YukiYuigishi/MEISHI/README.md

# MEISHI
[2022 v1.0](https://github.com/YukiYuigishi/MEISHI/tree/master/PCB/MEISHI2022)
