YukiYuigishi/MEISHI/PCB/MEISHI2022/PDF/MEISHI_Schema.pdf

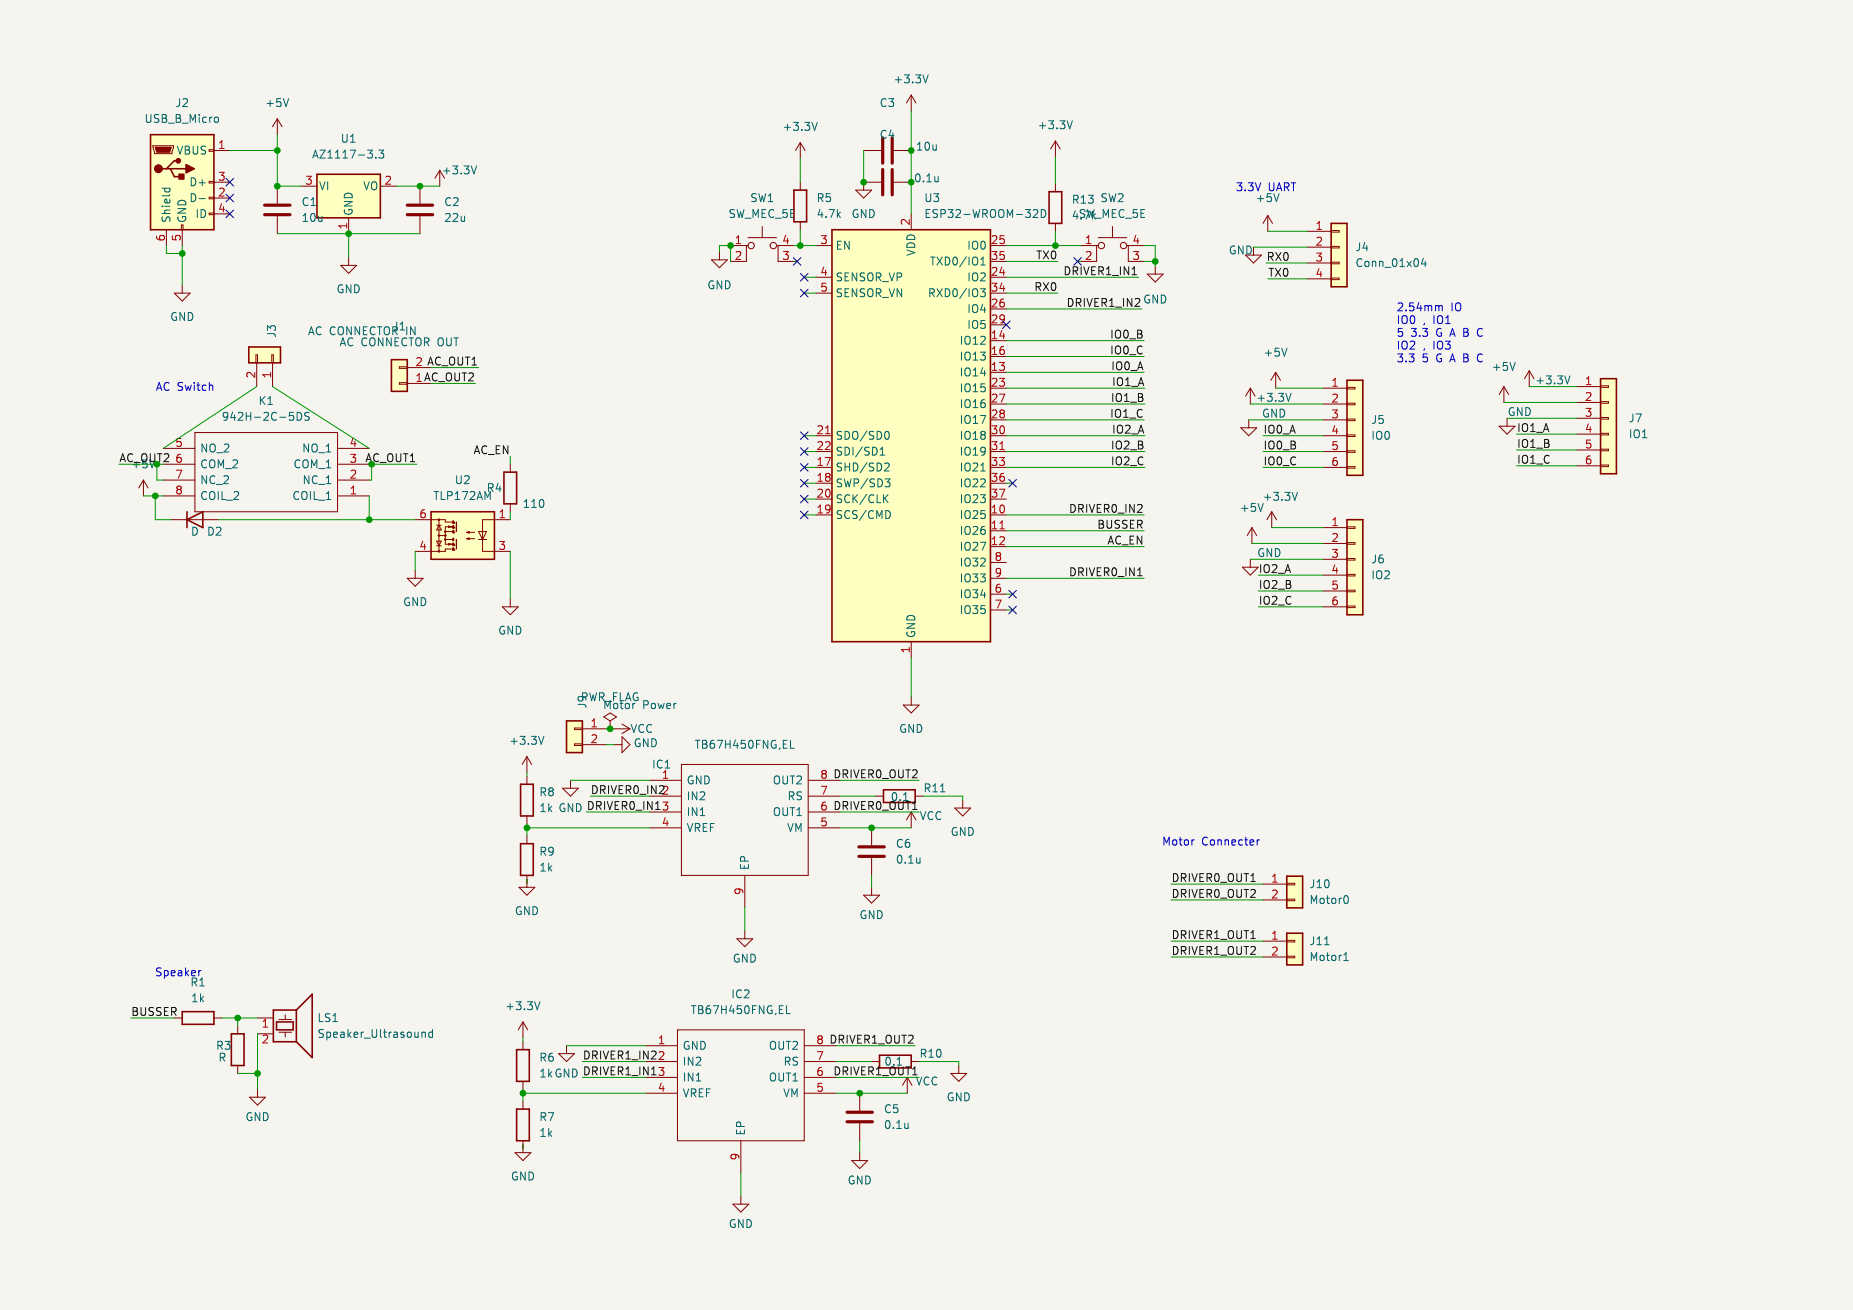
[picture p1: page 1]
