YukiYuigishi/MEISHI/PCB/MEISHI2023/MEISHI.kicad_pcb

## KiCad design PCB/MEISHI2023/MEISHI.kicad_pcb (2023-08-06)

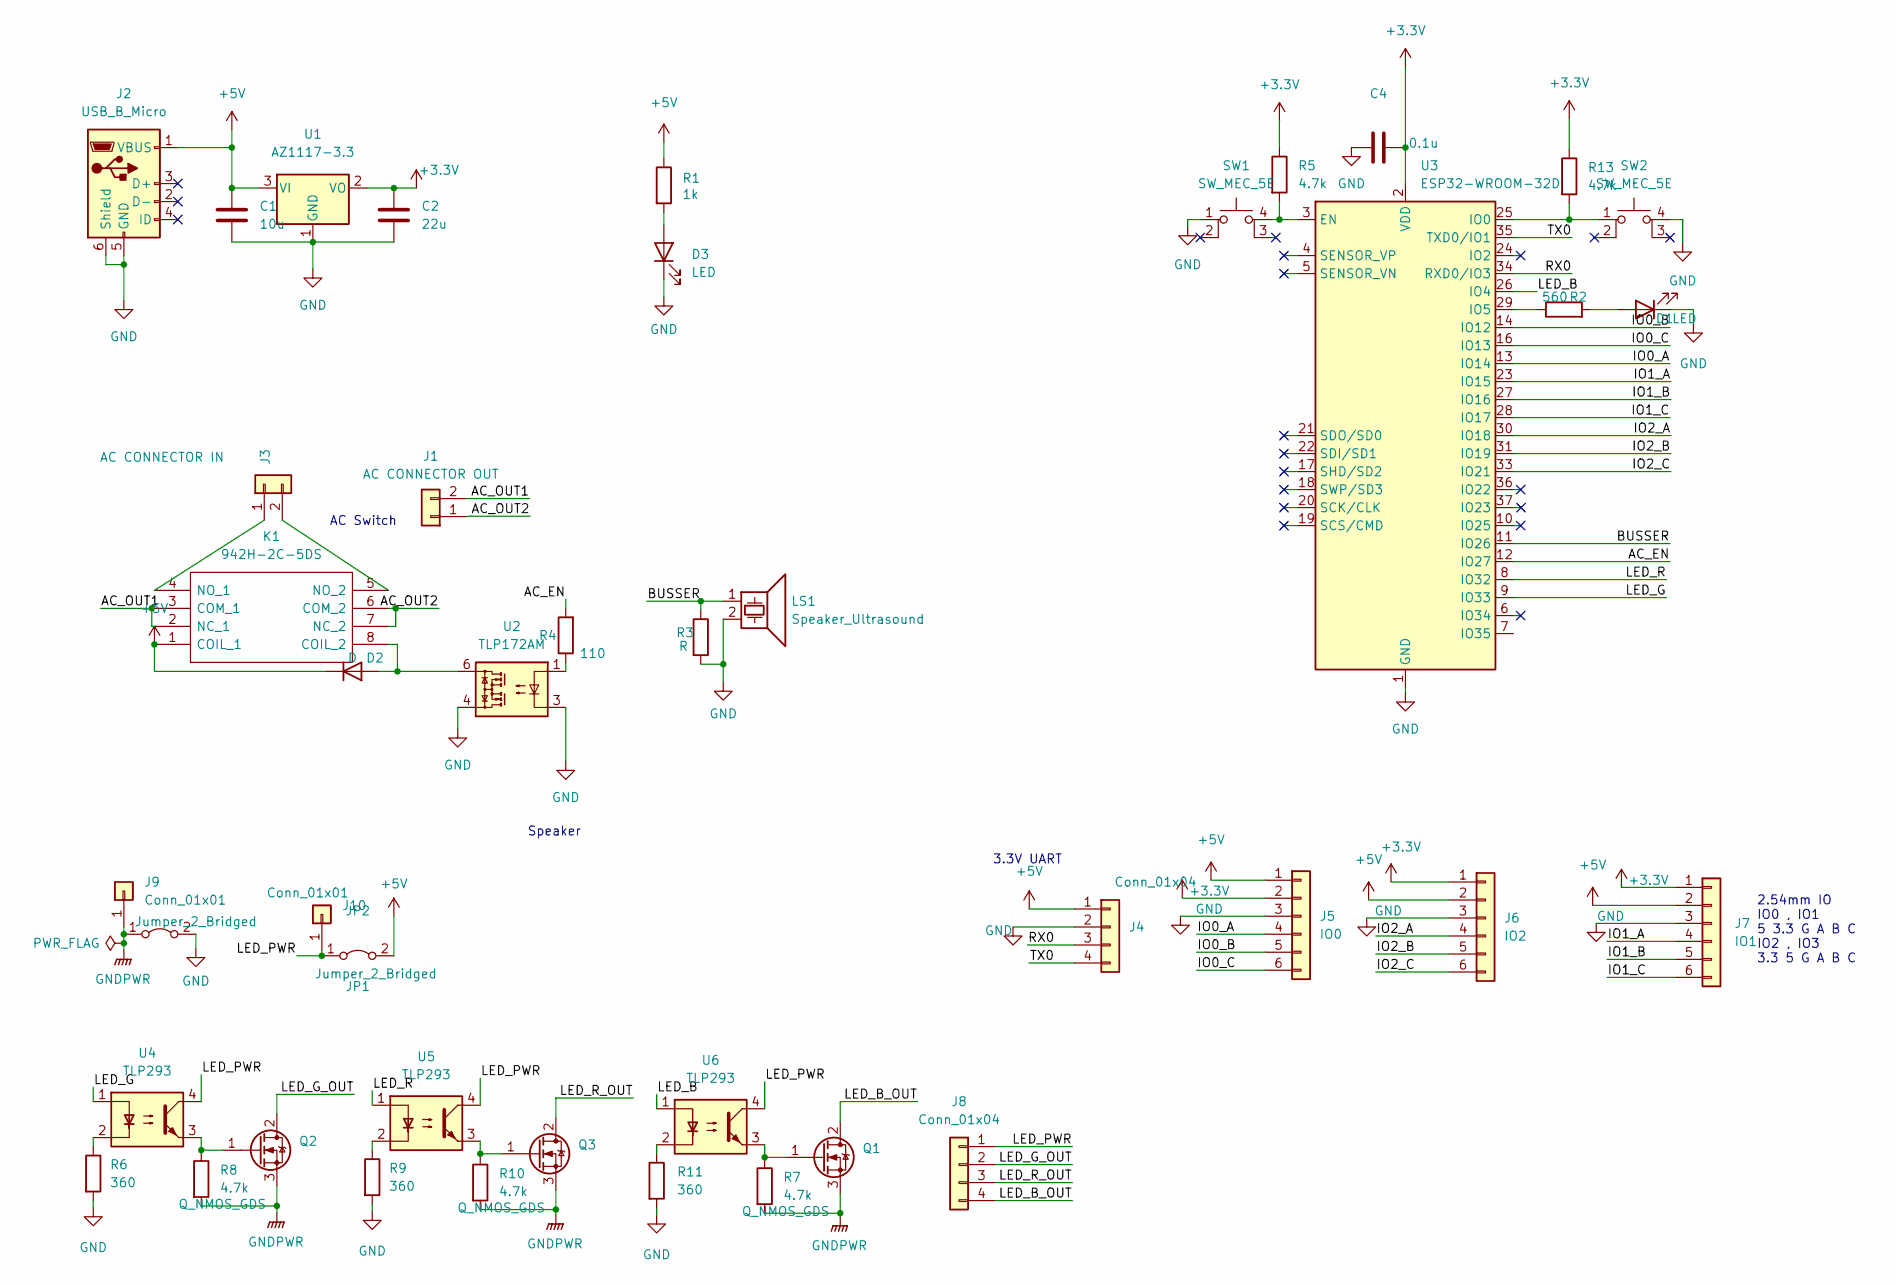
[picture p2: schematic MEISHI.kicad_sch]

Parts:
C1: 10u; C_0805_2012Metric_Pad1.18x1.45mm_HandSolder
C2: 22u; C_0805_2012Metric_Pad1.18x1.45mm_HandSolder
C4: 0.1u; C_0805_2012Metric_Pad1.18x1.45mm_HandSolder
D1, D3: LED; LED_0603_1608Metric_Pad1.05x0.95mm_HandSolder
D2: D; D_SOD-128
J1: AC CONNECTOR OUT; JST_VH_B2P-VH_1x02_P3.96mm_Vertical
J2: USB_B_Micro; Micro-USB-J91(Marutsu)
J3: AC CONNECTOR IN; JST_VH_B2P-VH_1x02_P3.96mm_Vertical
J4, J8: Conn_01x04; JST_XH_B4B-XH-A_1x04_P2.50mm_Vertical
J5: IO0; JST_XH_B6B-XH-A_1x06_P2.50mm_Vertical
J6: IO2; JST_XH_B6B-XH-A_1x06_P2.50mm_Vertical
J7: IO1; JST_XH_B6B-XH-A_1x06_P2.50mm_Vertical
J9, J10: Conn_01x01; SolderWirePad_1x01_SMD_5x10mm
JP1: Jumper_2_Bridged; SolderJumper-2_P1.3mm_Open_RoundedPad1.0x1.5mm
JP2: Jumper_2_Bridged; D_SOD-123F
K1: 942H-2C-5DS; 942H2C5DS; Manufacturer_Part_Number 942H-2C-5DS
LS1: Speaker_Ultrasound; Buzzer_TDK_PS1240P02BT_D12.2mm_H6.5mm
Q1, Q2, Q3: Q_NMOS_GDS; TO-252-2
R1: 1k; R_0603_1608Metric_Pad0.98x0.95mm_HandSolder
R2: 560; R_0603_1608Metric_Pad0.98x0.95mm_HandSolder
R3: R; R_0603_1608Metric_Pad0.98x0.95mm_HandSolder
R4: 110; R_0603_1608Metric_Pad0.98x0.95mm_HandSolder
R5, R7, R8, R10, R13: 4.7k; R_0603_1608Metric_Pad0.98x0.95mm_HandSolder
R6, R9, R11: 360; R_0603_1608Metric_Pad0.98x0.95mm_HandSolder
SW1, SW2: SW_MEC_5E; SKRPABE010
U1: AZ1117-3.3; SOT-223-3_TabPin2
U2: TLP172AM; MFSOP6-4_4.4x3.6mm_P1.27mm
U3: ESP32-WROOM-32D; ESP32-WROOM-32
U4, U5, U6: TLP293; SOIC-4_4.55x2.6mm_P1.27mm

Connections:
+3V3: C2.1, C4.2, J5.2, J6.1, J7.1, R5.1, R13.1, U1.2 (VO), U3.2 (VDD)
+5V: C1.1, D2.1 (K), J2.1 (VBUS), J4.1, J5.1, J6.2, J7.2, JP2.2 (B), K1.1 (COIL_1), R1.1, U1.3 (VI)
/AC_EN: R4.2, U3.12 (IO27)
/AC_OUT1: J1.2, K1.2 (NC_1), K1.3 (COM_1)
/AC_OUT2: J1.1, K1.6 (COM_2), K1.7 (NC_2)
/BUSSER: LS1.1, R3.1, U3.11 (IO26)
/IO0_A: J5.4, U3.13 (IO14)
/IO0_B: J5.5, U3.14 (IO12)
/IO0_C: J5.6, U3.16 (IO13)
/IO1_A: J7.4, U3.23 (IO15)
/IO1_B: J7.5, U3.27 (IO16)
/IO1_C: J7.6, U3.28 (IO17)
/IO2_A: J6.4, U3.30 (IO18)
/IO2_B: J6.5, U3.31 (IO19)
/IO2_C: J6.6, U3.33 (IO21)
/LED_B: U3.26 (IO4), U6.1
/LED_B_OUT: J8.4, Q1.2 (D)
/LED_G: U3.9 (IO33), U4.1
/LED_G_OUT: J8.2, Q2.2 (D)
/LED_PWR: J8.1, J10.1, JP2.1 (A), U4.4, U5.4, U6.4
/LED_R: U3.8 (IO32), U5.1
/LED_R_OUT: J8.3, Q3.2 (D)
/RX0: J4.3, U3.34 (RXD0/IO3)
/TX0: J4.4, U3.35 (TXD0/IO1)
GND: C1.2, C2.2, C4.1, D1.1 (K), D3.1 (K), J2.5 (GND), J2.6 (Shield), J4.2, J5.3, J6.3, J7.3, JP1.2 (B), LS1.2, R3.2, R6.2, R9.2, R11.2, SW1.1, SW2.4 (A), U1.1 (GND), U2.3, U2.4, U3.1 (GND), U3.15 (GND), U3.38 (GND), U3.39 (GND)
GNDPWR: J9.1, JP1.1 (A), Q1.3 (S), Q2.3 (S), Q3.3 (S), R7.2, R8.2, R10.2
unnamed: D1.2 (A), R2.2
unnamed: D2.2 (A), K1.8 (COIL_2), U2.6
unnamed: D3.2 (A), R1.2
unnamed: J3.1, K1.4 (NO_1)
unnamed: J3.2, K1.5 (NO_2)
unnamed: Q1.1 (G), R7.1, U6.3
unnamed: Q2.1 (G), R8.1, U4.3
unnamed: Q3.1 (G), R10.1, U5.3
unnamed: R2.1, U3.29 (IO5)
unnamed: R4.1, U2.1
unnamed: R5.2, SW1.4 (A), U3.3 (EN)
unnamed: R6.1, U4.2
unnamed: R9.1, U5.2
unnamed: R11.1, U6.2
unnamed: R13.2, SW2.1, U3.25 (IO0)

Notes on the sheet:
2.54mm IO IO0 , IO1 5 3.3 G A B C IO2 , IO3 3.3 5 G A B C
Speaker
AC Switch
3.3V UART

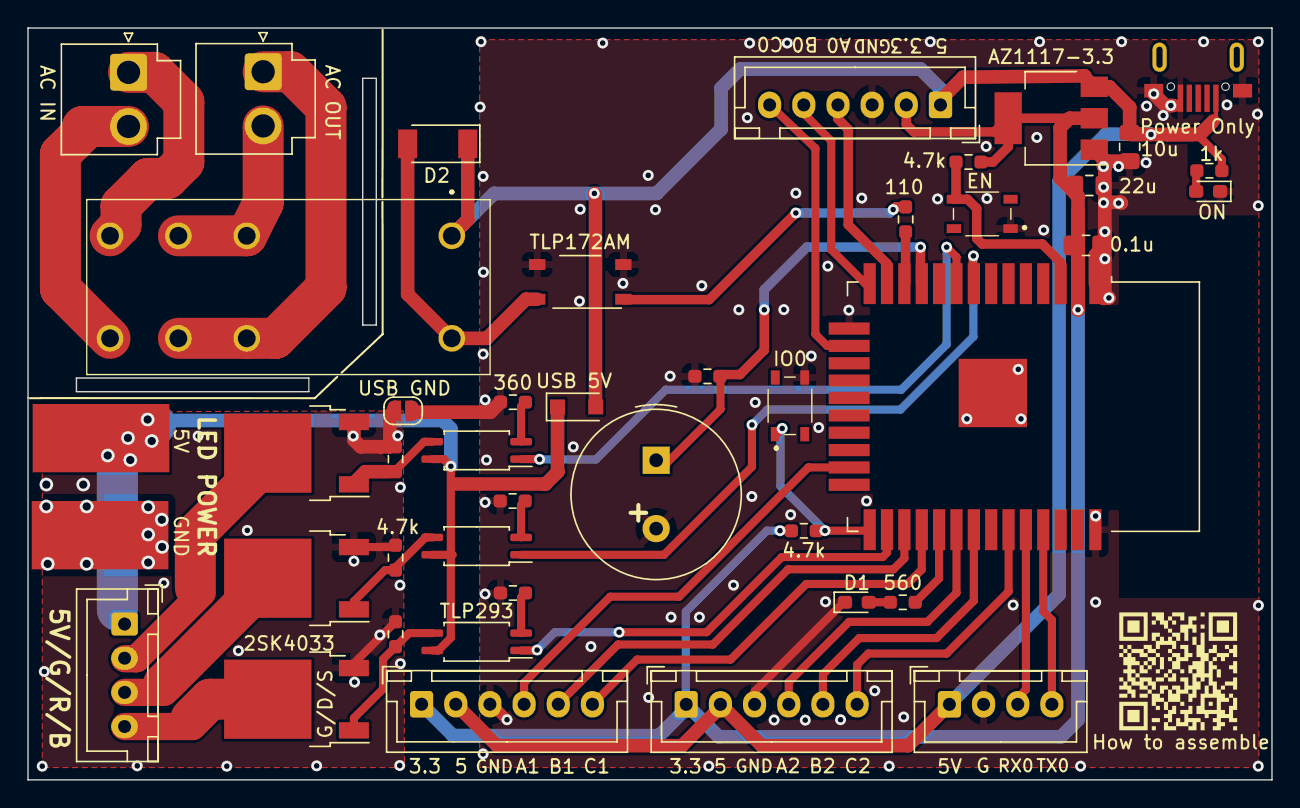
[picture p3: board MEISHI.kicad_pcb from above]

Board: 2 copper layers, 91.0 x 55.0 mm, 43 parts (0 on the bottom side), 41 nets.
