YukiYuigishi/MEISHI/(commit log)

2022-06-02 add WIP PCB
    [MEISHI.kicad_pcb, MEISHI.kicad_sch]
2022-06-05 rename MEISHI DIR
    [MEISHI.kicad_pcb, MEISHI.kicad_sch]
2022-06-05 reorder files
    [MEISHI.kicad_pcb, MEISHI.kicad_sch]
2022-06-05 feat MEISHI
    [MEISHI.kicad_pcb, MEISHI.kicad_sch]
2022-06-08 fix pcb
    [MEISHI.kicad_pcb, MEISHI.kicad_sch]
